Meteors27/RobotTeamwork/SonarTest/SonarTest.ino

// 1 滤波
// 2 最远距离 50 cm
// 3 由于大于最远距离时echopin得到输入 0 cm, 因此有效数值应大于 5 cm

#include <NewPing.h>

#define TRIGGER_PIN  (22)
#define ECHO_PIN     (23)
#define MAX_DISTANCE 80 // Maximum distance we want to ping for (in centimeters). Maximum sensor distance is rated at 400-500cm.

NewPing sonar(TRIGGER_PIN, ECHO_PIN, MAX_DISTANCE); // NewPing setup of pins and maximum distance.

void setup() {
  Serial.begin(9600); // Open serial monitor at 115200 baud to see ping results.
}

void loop() {
  delay(50);                     // Wait 50ms between pings (about 20 pings/sec). 29ms should be the shortest delay between pings.
  Serial.print("Ping: ");
  Serial.print(sonar.ping_cm()); // Send ping, get distance in cm and print result (0 = outside set distance range)
  Serial.println("cm");
}
