Meteors27/RobotTeamwork/(commit log)

2022-09-01 已知问题：
2022-09-01 已知问题：1 路口右转时长过多; 2 掉头后的程序不能按照规定路线运行
2022-09-01 更新依赖库文件内容
2022-09-01 已知问题：1 三岔路口右转后直行时间过长; 2 掉头后程序有不明原因bug
2022-09-02 add steering engine test code
2022-09-02 add module for white label sensor
2022-09-02 add module for while label sensor
2022-09-02 add test for touch sensor(actuallly a force sensor)
2022-09-02 add RGB sensor
2022-09-02 目前：巡线有问题，边缘传感器基本正确。调整了边缘传感器的参数，修复了很多bug
2022-09-02 调整了巡线的参数，目前：可以巡线，有点抖，cournerCount机制有问题
2022-09-02 更新格式
2022-09-02 修改ignore的内容
2022-09-02 修复不需跟踪的文件
2022-09-03 修改IS_OBSTACLE判断规则
2022-09-03 目前：避障问题，进岔路口姿态偏右
2022-09-03 更改最大距离为80 提前转弯
2022-09-03 禁用边缘传感器，试试能不能在避障之后正常左转回到线上。
2022-09-03 下坡后在巡线内右转（本应左转
2022-09-03 到换线巡线前一切正常
2022-09-03 整理测试代码
2022-09-03 美化代码
2022-09-03 无法检测到障碍物
2022-09-03 能够检测障碍物，且能进入蓝灯避障，但无法正常回到线上
2022-09-03 能够走到60行，但后面因为上线角度太大而冲出线外
2022-09-03 正常巡线两圈。
2022-09-03 原程序测试通过，但过障碍的时候是擦边通过的，本版程序更改51行为delay(600)
2022-09-03 达成了丝滑巡线
2022-09-03 装载机械臂后能稳定循迹 | 调整了避障参数
2022-09-04 把边缘传感器的参数放到了主程序中
2022-09-04 updated camera & color detection
2022-09-04 在有负重的情况下能够正常上坡，但停在路口时的姿态偏右
2022-09-04 调整边缘传感器位置后现在基本能够正对台面停止
2022-09-04 提高了循迹速度，还有其他参数没调
2022-09-04 无法正常走完一圈，异常触发避障
2022-09-04 现在能够正常过三岔路口
2022-09-04 正常巡线
2022-09-04 (希望)能够正常巡线（避障未测试）
2022-09-04 右转开环
2022-09-04 读秒循迹，较为稳定
2022-09-04 调整参数，比较稳定
2022-09-04 除了turnleft有小概率导致下坡方向偏右不能巡线，其他正常
2022-09-04 提交9月4日最终版本
2022-09-04 added and formatted **servos**
2022-09-04 merge后：巡线测试正常，目前版本为grasping中会停止于工作台前版本
2022-09-05 初步merge，优化代码结构，但grasp和place没有分开
2022-09-05 增加颜色传感器库
2022-09-05 增加颜色传感器test.ino
2022-09-05 更新颜色检测test
2022-09-05 重新接线，更改引脚
2022-09-05 重新接线，更改引脚，但机械臂参数非最新
2022-09-05 更新舵机引脚
2022-09-05 巡线正常，微调机械臂参数
2022-09-05 调整机械臂参数
2022-09-05 之前版rotate_to有误。本版本巡线基本正常，机械臂在初始化后需马上调整姿态，机械臂其他参数待调
2022-09-06 增加抓取和放下控制代码
2022-09-06 删除语法错误
2022-09-06 调整引脚
2022-09-06 换舵机后机械臂抓取正常
2022-09-06 加入多电机并行控制函数（未测试）
2022-09-06 添加电机并行控制代码（未测试）
2022-09-06 加入电机并行控制函数，但没有测试
2022-09-06 舵机并行控制实现（应该是）成功
2022-09-06 抓取左边物体时会打倒其余两个，其余抓取测试正常，可考虑先抓右边的
2022-09-06 更改边缘阈值
2022-09-06 更改阈值
2022-09-06 增加颜色传感相关模块，ColorDetectTest.ino能正确识别
2022-09-06 实现：抓取顺序右中左，转盘初始化阶段调到5，缩短转盘运动距离；未完成：转盘转动和抓取并行
2022-09-06 提速，取消delay 最快28s
2022-09-06 实现抓取（位置有点偏，有时候放不太稳）
2022-09-06 修改颜色传感器库
2022-09-06 合并程序
2022-09-06 合并第二版，路口正常，机械臂一般
2022-09-06 9.6晚，机械臂参数调整
2022-09-06 更改库文件，适配新的颜色传感器
2022-09-06 更改mega引脚
2022-09-06 合并版本3，加入颜色传感器测试
2022-09-06 合并版本3，加入颜色传感器测试(更正)
2022-09-06 调整颜色传感器绿色判定参数
2022-09-06 停在路口的位置偏右（线在左），姿态正确，下坡过快导致巡线失败
2022-09-06 下坡减速成功
2022-09-06 更新最终版
2022-09-06 不稳定成功
2022-09-07 40~70%电量 电压11.6~11.9V，能正常巡线，停得正时放置偏右
2022-09-07 超声波一次使用永久disable（便于调试）
2022-09-07 调节block_placing参数，放置偏远，但角度基本准确
2022-09-07 添加了制动函数
2022-09-07 主程序提交左转右转修改，测试程序修改了参数
2022-09-07 修改机械臂参数
2022-09-07 更新主程序参数
2022-09-07 调参，目前测试版本能够比较稳定放置
2022-09-07 增加了下排三个抓取
2022-09-07 合并版本，未测试
2022-09-07 调整第一次sprint区间
2022-09-07 策略1：第一圈就抓六个，丢掉其中三个（其他策略在其他分支）
2022-09-07 robot主程序改进了初始化舵机，修改了turnright函数，变为传感器三级检测， placingtest改为placing的test
2022-09-07 更改颜色传感器识别规则，robot.ino抓取有问题
2022-09-07 grasping和placing路口拐弯巡线一致性强，placing机械臂参数正确，机械臂lower会随机疲软，grasping机械臂参数需要微调
2022-09-07 perfect! 实现抓6放3
2022-09-08 舵机更换，抓取小问题
2022-09-08 抓取存在硬件问题|过早的避障调用
2022-09-08 调整上placing台阶的参数
2022-09-08 调整最近的三个抓取
2022-09-08 完美成功代码
2022-09-11 后续代码维护：更新readme，调整文件结构
