Meteors27/RobotTeamwork/机器人基础实践报告 25c03f8a334842ea8003ac9e75345d85/6FA579C1-2B17-4A1C-AE78-A883615F0561.jpeg

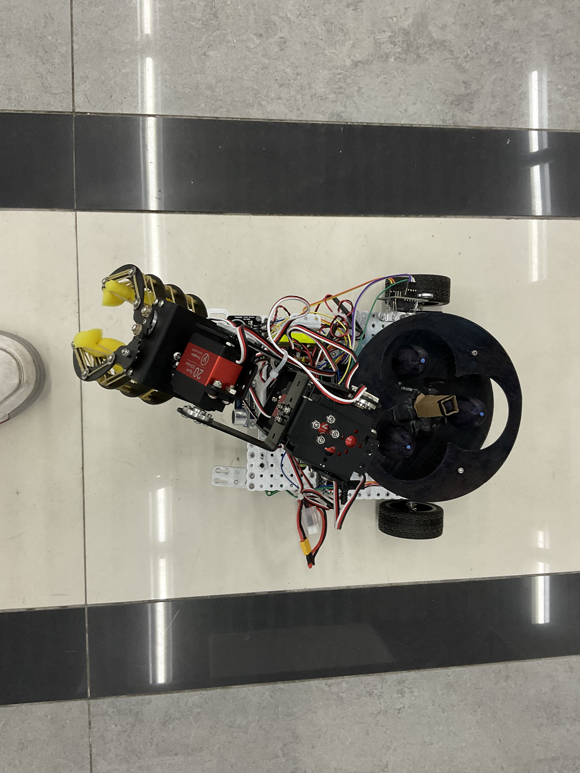
[picture p15: 机器人基础实践报告 25c03f8a334842ea8003ac9e75345d85/6FA579C1-2B17-4A1C-AE78-A883615F0561.jpeg]
机器人基础实践报告 25c03f8a334842ea8003ac9e75345d85/6FA579C1-2B17-4A1C-AE78-A883615F0561.jpeg
